diagnostic-prognostic-lab/ElbiCare/PCB/PicoAcoustic v3/PicoAcoustic v3.kicad_pcb

## KiCad design PCB/PicoAcoustic v3/PicoAcoustic v3.kicad_pcb (2026-11-07)

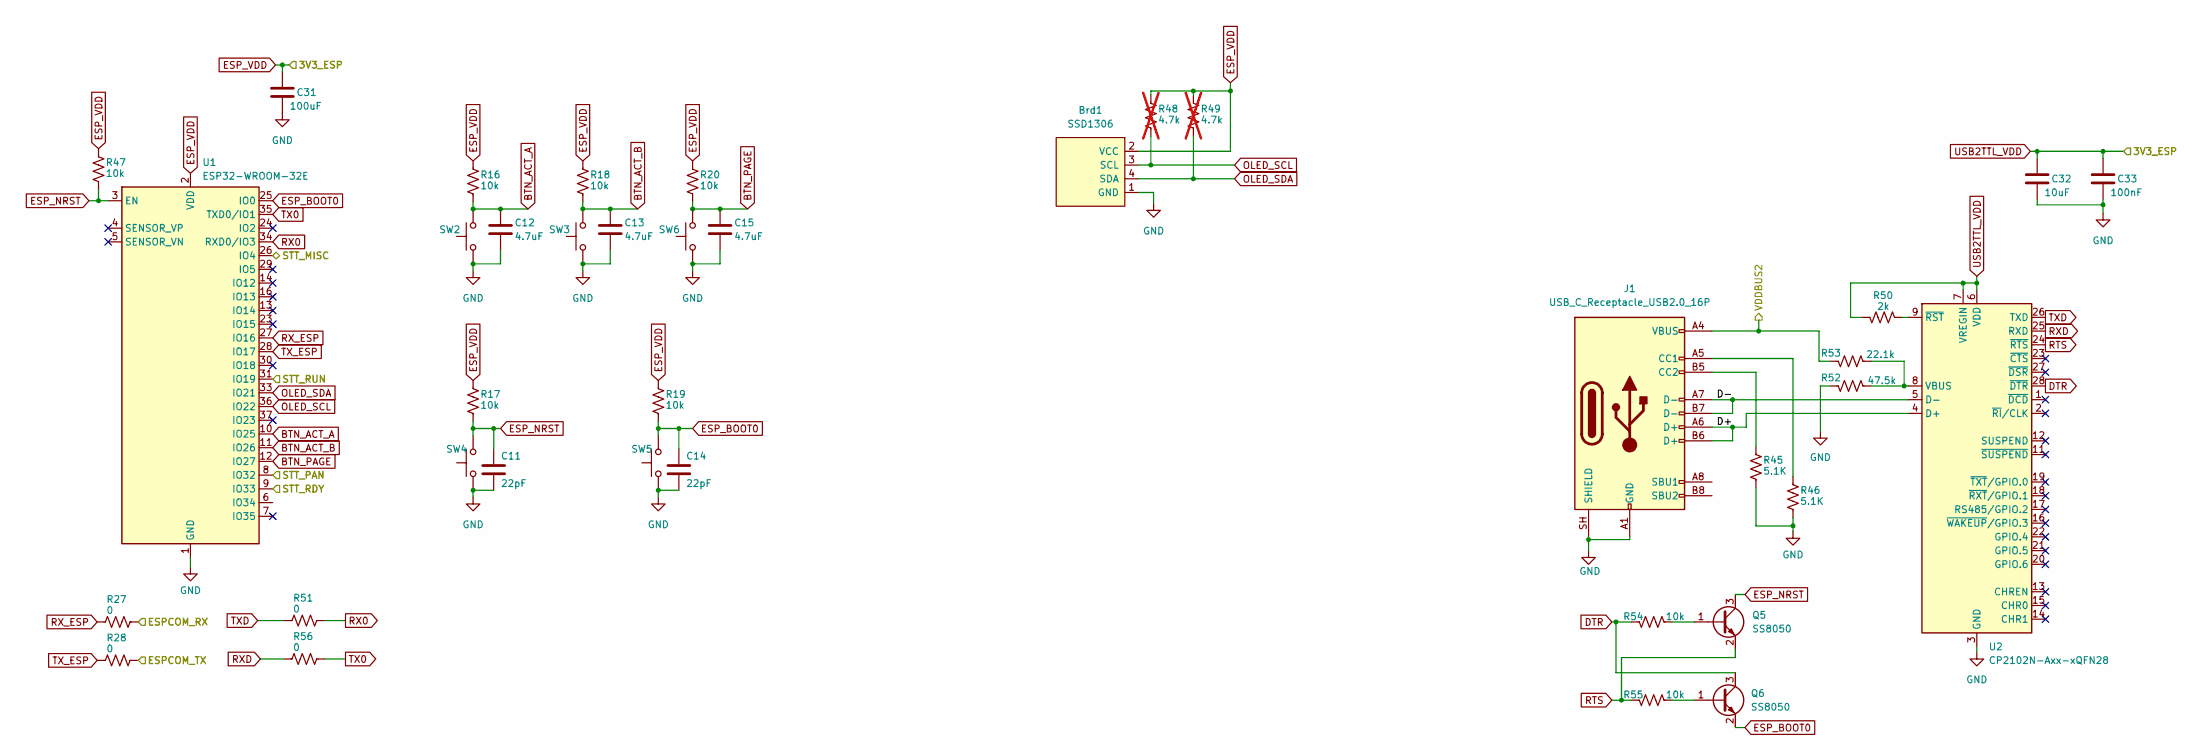
[picture p1: schematic esp32.kicad_sch]

Parts:
Brd1: SSD1306; LCD_OLED_128X64_1.3_I2C
C11, C14: 22pF; C_0603_1608Metric
C12, C13, C15: 4.7uF; C_0603_1608Metric
C31: 100uF; C_0603_1608Metric
C32: 10uF; C_0805_2012Metric
C33: 100nF; C_0603_1608Metric
J1: USB_C_Receptacle_USB2.0_16P; USB_C_Receptacle_G-Switch_GT-USB-7010ASV
Q5, Q6: SS8050; SOT-23
R16, R17, R18, R19, R20, R47, R54, R55: 10k; R_0603_1608Metric
R27, R28, R51, R56: 0; R_0603_1608Metric
R45, R46: 5.1K; R_0603_1608Metric
R48, R49: 4.7k; R_0603_1608Metric; not fitted
R50: 2k; R_0603_1608Metric
R52: 47.5k; R_0603_1608Metric
R53: 22.1k; R_0603_1608Metric
SW2, SW3, SW4, SW5, SW6: SW_Push; SW_PUSH_6mm_H13mm
U1: ESP32-WROOM-32E; ESP32-WROOM-32D
U2: CP2102N-Axx-xQFN28; QFN-28-1EP_5x5mm_P0.5mm_EP3.25x3.25mm_ThermalVias

Connections:
/ESP32/D+: J1.A6 (D+), J1.B6 (D+), U2.4 (D+)
/ESP32/D-: J1.A7 (D-), J1.B7 (D-), U2.5 (D-)
/ESP32/ESPCOM_RX: R27.2; also elsewhere on the board
/ESP32/ESPCOM_TX: R28.2; also elsewhere on the board
/ESP32/STT_MISC: U1.26 (IO4); also elsewhere on the board
/ESP32/STT_PAN: U1.8 (IO32); also elsewhere on the board
/ESP32/STT_RDY: U1.9 (IO33); also elsewhere on the board
/ESP32/STT_RUN: U1.31 (IO19); also elsewhere on the board
/ESP32/VDDBUS2: J1.A4 (VBUS), J1.A9 (VBUS), J1.B4 (VBUS), J1.B9 (VBUS), R53.2; also elsewhere on the board
BTN_ACT_A: C12.1, R16.2, SW2.2, U1.10 (IO25)
BTN_ACT_B: C13.1, R18.2, SW3.2, U1.11 (IO26)
BTN_PAGE: C15.1, R20.2, SW6.2, U1.12 (IO27)
DTR: Q6.3 (C), R54.2, U2.28 (~DTR)
ESP_BOOT0: C14.1, Q6.2 (E), R19.2, SW5.2, U1.25 (IO0)
ESP_NRST: C11.1, Q5.3 (C), R17.2, R47.2, SW4.2, U1.3 (EN)
ESP_VDD: Brd1.2 (VCC), C31.1, C32.1, C33.1, R16.1, R17.1, R18.1, R19.1, R20.1, R47.1, R48.1, R49.1, R50.2, U1.2 (VDD), U2.6 (VDD), U2.7 (VREGIN); also elsewhere on the board
GND: Brd1.1 (GND), C11.2, C12.2, C13.2, C14.2, C15.2, C31.2, C32.2, C33.2, J1.A1 (GND), J1.A12 (GND), J1.B1 (GND), J1.B12 (GND), J1.SH (SHIELD), R45.2, R46.2, R52.2, SW2.1, SW3.1, SW4.1, SW5.1, SW6.1, U1.1 (GND), U1.15 (GND), U1.38 (GND), U1.39 (GND), U2.3 (GND), U2.29 (GND); also elsewhere on the board
unnamed: J1.A5 (CC1), R46.1
unnamed: J1.B5 (CC2), R45.1
unnamed: Q5.1 (B), R54.1
unnamed: Q6.1 (B), R55.1
unnamed: R52.1, R53.1, U2.8 (VBUS)
unnamed: R50.1, U2.9 (~RST)
OLED_SCL: Brd1.3 (SCL), R48.2, U1.36 (IO22)
OLED_SDA: Brd1.4 (SDA), R49.2, U1.33 (IO21)
RTS: Q5.2 (E), R55.2, U2.24 (~RTS)
RX0: R51.2, U1.34 (RXD0/IO3)
RXD: R56.1, U2.25 (RXD)
RX_ESP: R27.1, U1.27 (IO16)
TX0: R56.2, U1.35 (TXD0/IO1)
TXD: R51.1, U2.26 (TXD)
TX_ESP: R28.1, U1.28 (IO17)

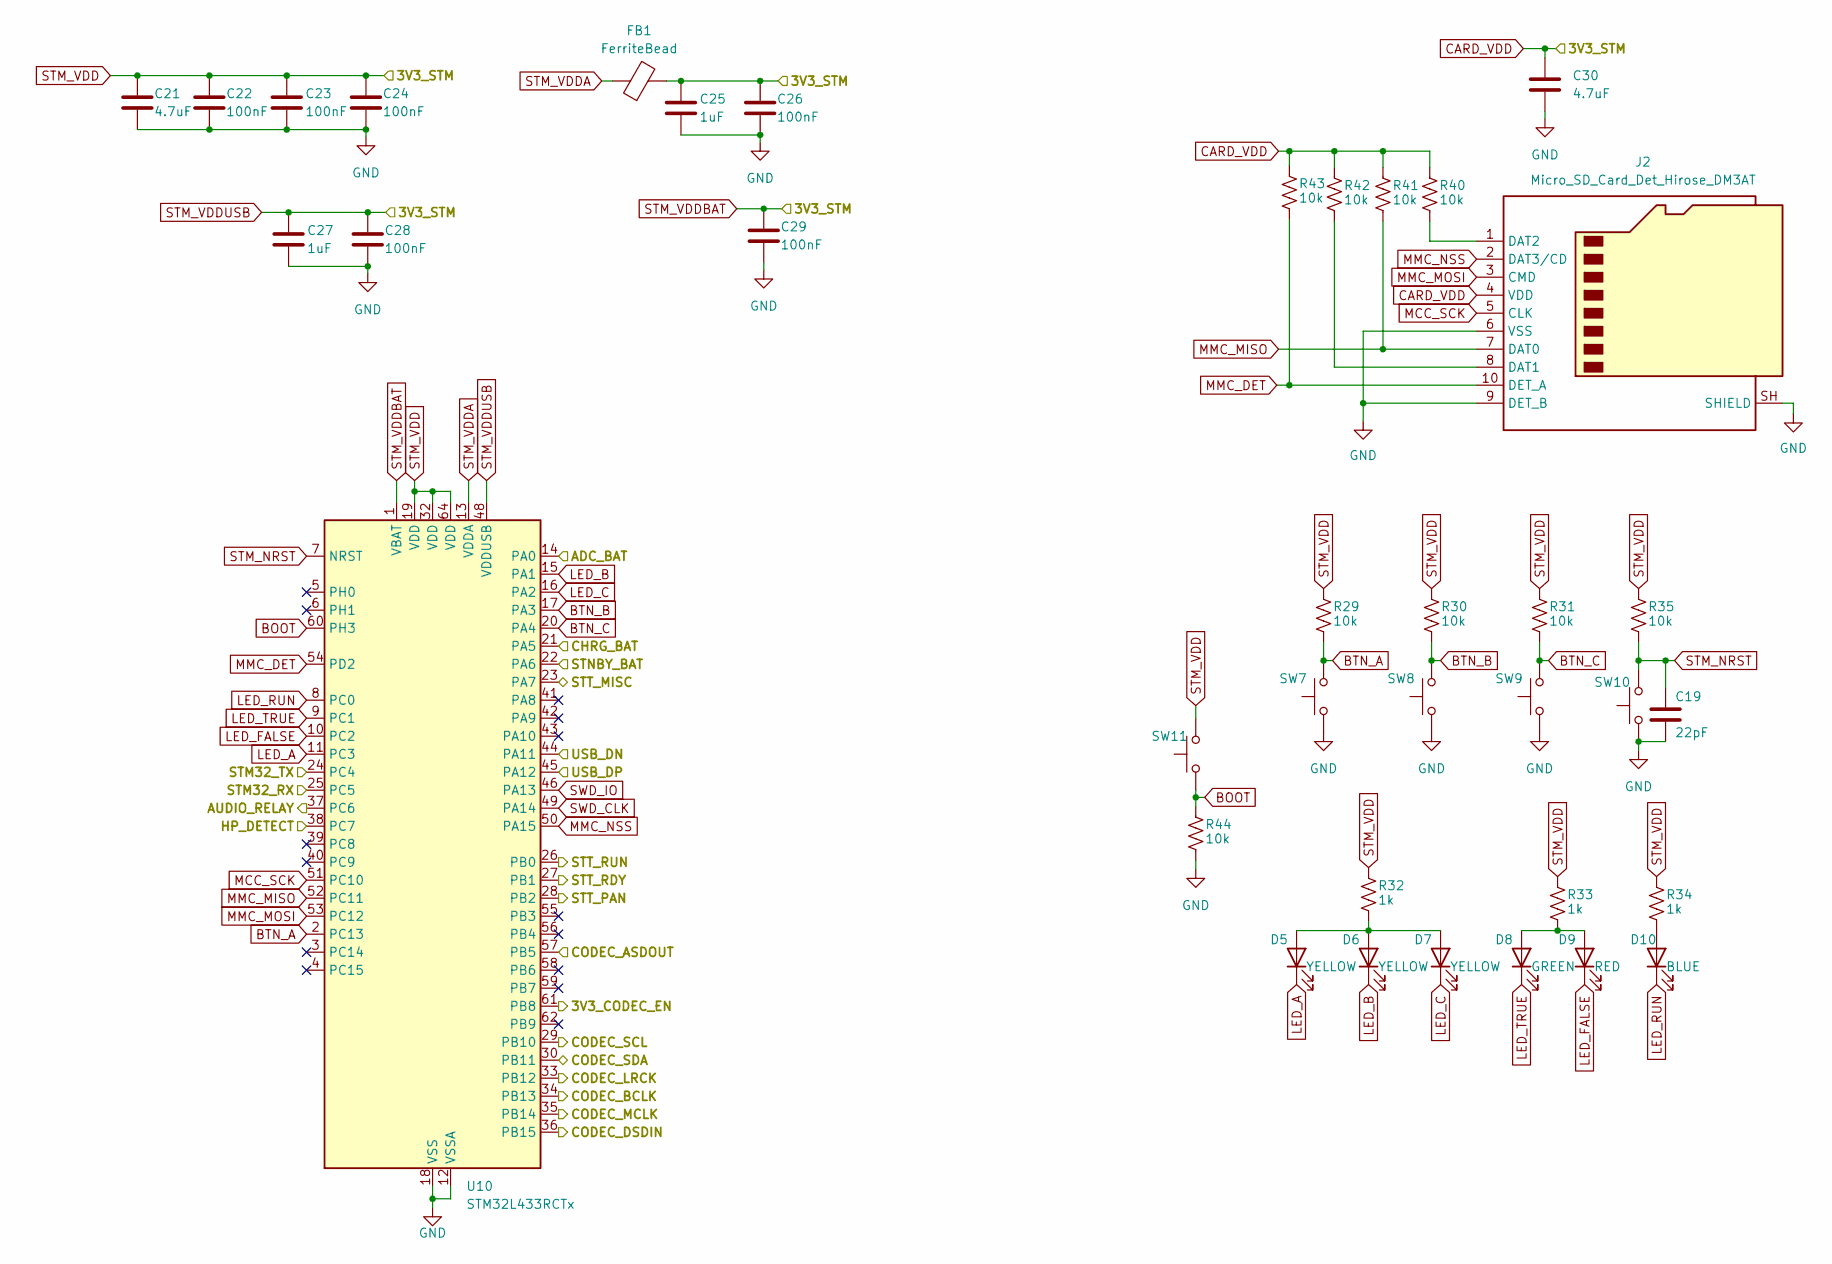
[picture p2: schematic stm32.kicad_sch]

Parts:
C19: 22pF; C_0603_1608Metric
C21, C30: 4.7uF; C_0603_1608Metric
C22, C23, C24, C26, C28, C29: 100nF; C_0603_1608Metric
C25, C27: 1uF; C_0603_1608Metric
D5, D6, D7: YELLOW; LED_0603_1608Metric
D8: GREEN; LED_0603_1608Metric
D9: RED; LED_0603_1608Metric
D10: BLUE; LED_0603_1608Metric
FB1: FerriteBead; L_0603_1608Metric
J2: Micro_SD_Card_Det_Hirose_DM3AT; microSD_HC_Hirose_DM3AT-SF-PEJM5
R29, R30, R31, R35, R40, R41, R42, R43, R44: 10k; R_0603_1608Metric
R32, R33, R34: 1k; R_0603_1608Metric
SW7, SW8, SW9, SW10, SW11: SW_Push; SW_PUSH_6mm_H13mm
U10: STM32L433RCTx; LQFP-64_10x10mm_P0.5mm

Connections:
/Analog Line/AUDIO_RELAY: U10.37 (PC6); also elsewhere on the board
/Analog Line/CODEC_ASDOUT: U10.57 (PB5); also elsewhere on the board
/Analog Line/CODEC_DSDIN: U10.36 (PB15); also elsewhere on the board
/Analog Line/CODEC_LRCK: U10.33 (PB12); also elsewhere on the board
/Analog Line/CODEC_MCLK: U10.35 (PB14); also elsewhere on the board
/Analog Line/CODEC_SCL: U10.29 (PB10); also elsewhere on the board
/Analog Line/CODEC_SCLK: U10.34 (PB13); also elsewhere on the board
/Analog Line/CODEC_SDA: U10.30 (PB11); also elsewhere on the board
/Analog Line/HP_DETECT: U10.38 (PC7); also elsewhere on the board
/ESP32/ESPCOM_RX: U10.24 (PC4); also elsewhere on the board
/ESP32/ESPCOM_TX: U10.25 (PC5); also elsewhere on the board
/ESP32/STT_MISC: U10.23 (PA7); also elsewhere on the board
/ESP32/STT_PAN: U10.28 (PB2); also elsewhere on the board
/ESP32/STT_RDY: U10.27 (PB1); also elsewhere on the board
/ESP32/STT_RUN: U10.26 (PB0); also elsewhere on the board
/Power Line/3V3_CODEC_EN: U10.61 (PB8); also elsewhere on the board
/Power Line/STM_DN: U10.44 (PA11); also elsewhere on the board
/Power Line/STM_DP: U10.45 (PA12); also elsewhere on the board
/Power Line/VBAT_SENSE: U10.14 (PA0); also elsewhere on the board
BOOT: R44.1, SW11.1, U10.60 (PH3)
BTN_A: R29.2, SW7.2, U10.2 (PC13)
BTN_B: R30.2, SW8.2, U10.17 (PA3)
BTN_C: R31.2, SW9.2, U10.20 (PA4)
CARD_VDD: C21.1, C22.1, C23.1, C24.1, C25.1, C26.1, C27.1, C28.1, C29.1, C30.1, FB1.2, J2.4 (VDD), R29.1, R30.1, R31.1, R32.1, R33.1, R34.1, R35.1, R40.1, R41.1, R42.1, R43.1, SW11.2, U10.1 (VBAT), U10.19 (VDD), U10.32 (VDD), U10.48 (VDDUSB), U10.64 (VDD); also elsewhere on the board
CHRG: U10.21 (PA5); also elsewhere on the board
GND: C19.2, C21.2, C22.2, C23.2, C24.2, C25.2, C26.2, C27.2, C28.2, C29.2, C30.2, J2.6 (VSS), J2.9 (DET_B), J2.SH (SHIELD), R44.2, SW7.1, SW8.1, SW9.1, SW10.1, U10.12 (VSSA), U10.18 (VSS), U10.31 (VSS), U10.47 (VSS), U10.63 (VSS); also elsewhere on the board
LED_A: D5.1 (K), U10.11 (PC3)
LED_B: D6.1 (K), U10.15 (PA1)
LED_C: D7.1 (K), U10.16 (PA2)
LED_FALSE: D9.1 (K), U10.10 (PC2)
LED_RUN: D10.1 (K), U10.8 (PC0)
LED_TRUE: D8.1 (K), U10.9 (PC1)
MCC_SCK: J2.5 (CLK), U10.51 (PC10)
MMC_DET: J2.10 (DET_A), R43.2, U10.54 (PD2)
MMC_MISO: J2.7 (DAT0), R41.2, U10.52 (PC11)
MMC_MOSI: J2.3 (CMD), U10.53 (PC12)
MMC_NSS: J2.2 (DAT3/CD), U10.50 (PA15)
unnamed: D5.2 (A), D6.2 (A), D7.2 (A), R32.2
unnamed: D8.2 (A), D9.2 (A), R33.2
unnamed: D10.2 (A), R34.2
unnamed: J2.8 (DAT1), R42.2
unnamed: J2.1 (DAT2), R40.2
STM_NRST: C19.1, R35.2, SW10.2, U10.7 (NRST)
STM_VDDA: FB1.1, U10.13 (VDDA)
STNBY: U10.22 (PA6); also elsewhere on the board
SWD_CLK: U10.49 (PA14)
SWD_IO: U10.46 (PA13)

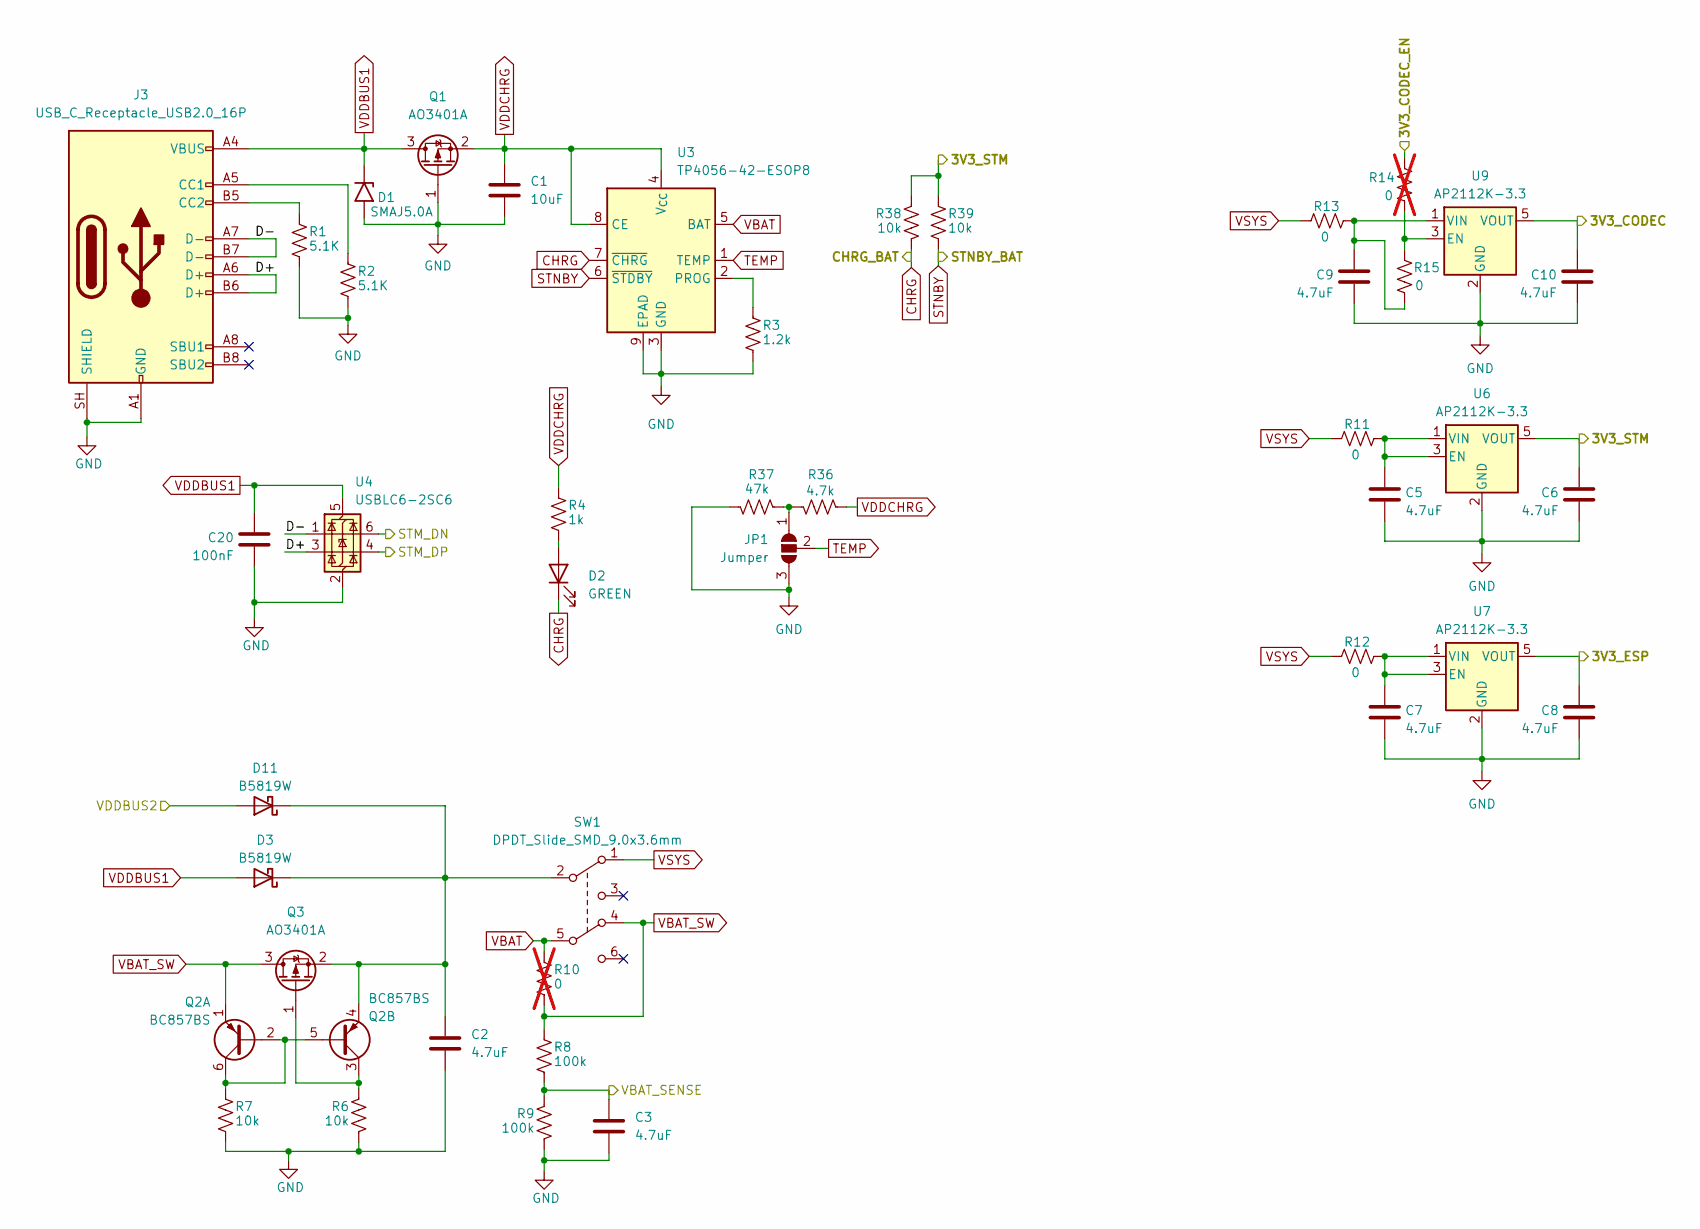
[picture p3: schematic power_line.kicad_sch]

Parts:
C1: 10uF; C_0603_1608Metric
C2, C3, C5, C6, C7, C8, C9, C10: 4.7uF; C_0603_1608Metric
C20: 100nF; C_0603_1608Metric
D1: SMAJ5.0A; D_SMA
D2: GREEN; LED_0603_1608Metric
D3, D11: B5819W; D_SMA
J3: USB_C_Receptacle_USB2.0_16P; USB_C_Receptacle_G-Switch_GT-USB-7010ASV
JP1: Jumper; SolderJumper-3_P1.3mm_Open_RoundedPad1.0x1.5mm_NumberLabels
Q1, Q3: AO3401A; SOT-23
Q2: BC857BS; SOT-363_SC-70-6
R1, R2: 5.1K; R_0603_1608Metric
R3: 1.2k; R_0603_1608Metric
R4: 1k; R_0603_1608Metric
R6, R7, R38, R39: 10k; R_0603_1608Metric
R8, R9: 100k; R_0603_1608Metric
R10, R14: 0; R_0603_1608Metric; not fitted
R11, R12, R13, R15: 0; R_0603_1608Metric
R36: 4.7k; R_0603_1608Metric
R37: 47k; R_0603_1608Metric
SW1: DPDT_Slide_SMD_9.0x3.6mm; SW_Push_2P2T_Toggle_CK_PVA2xxH1xxxxxxV2
U3: TP4056-42-ESOP8; SOIC-8-1EP_3.9x4.9mm_P1.27mm_EP2.41x3.3mm_ThermalVias
U4: USBLC6-2SC6; SOT-23-6
U6, U7, U9: AP2112K-3.3; SOT-23-5

Connections:
/ESP32/VDDBUS2: D11.2 (A); also elsewhere on the board
/Power Line/3V3_CODEC_EN: R14.2; also elsewhere on the board
/Power Line/D+: J3.A6 (D+), J3.B6 (D+), U4.3 (I/O2)
/Power Line/D-: J3.A7 (D-), J3.B7 (D-), U4.1 (I/O1)
/Power Line/STM_DN: U4.6 (I/O1); also elsewhere on the board
/Power Line/STM_DP: U4.4 (I/O2); also elsewhere on the board
/Power Line/VBAT_SENSE: C3.1, R8.2, R9.1; also elsewhere on the board
AVDD: C10.1, U9.5 (VOUT); also elsewhere on the board
CARD_VDD: C6.1, R38.1, R39.1, U6.5 (VOUT); also elsewhere on the board
CHRG: D2.1 (K), R38.2, U3.7 (~CHRG); also elsewhere on the board
ESP_VDD: C8.1, U7.5 (VOUT); also elsewhere on the board
GND: C1.2, C2.2, C3.2, C5.2, C6.2, C7.2, C8.2, C9.2, C10.2, C20.2, D1.2 (A2), J3.A1 (GND), J3.A12 (GND), J3.B1 (GND), J3.B12 (GND), J3.SH (SHIELD), JP1.3 (B), Q1.1 (G), R1.2, R2.2, R3.2, R6.2, R7.2, R9.2, R37.2, U3.3 (GND), U3.9 (EPAD), U4.2 (GND), U6.2 (GND), U7.2 (GND), U9.2 (GND); also elsewhere on the board
unnamed: D2.2 (A), R4.2
unnamed: C2.1, D3.1 (K), D11.1 (K), Q2.4 (E2), Q3.2 (S), SW1.2 (B)
unnamed: J3.A5 (CC1), R2.1
unnamed: J3.B5 (CC2), R1.1
unnamed: JP1.1 (A), R36.2, R37.1
unnamed: Q2.2 (B1), Q2.5 (B2), Q2.6 (C1), R7.1
unnamed: Q2.3 (C2), Q3.1 (G), R6.1
unnamed: R3.1, U3.2 (PROG)
unnamed: C5.1, R11.2, U6.1 (VIN), U6.3 (EN)
unnamed: C7.1, R12.2, U7.1 (VIN), U7.3 (EN)
unnamed: R14.1, R15.2, U9.3 (EN)
unnamed: C9.1, R13.2, R15.1, U9.1 (VIN)
STNBY: R39.2, U3.6 (~STDBY); also elsewhere on the board
TEMP: JP1.2 (C), U3.1 (TEMP)
VBAT: R10.1, SW1.5 (B), U3.5 (BAT)
VBAT_SW: Q2.1 (E1), Q3.3 (D), R8.1, R10.2, SW1.4 (A)
VDDBUS1: C20.1, D1.1 (A1), D3.2 (A), J3.A4 (VBUS), J3.A9 (VBUS), J3.B4 (VBUS), J3.B9 (VBUS), Q1.3 (D), U4.5 (VBUS)
VDDCHRG: C1.1, Q1.2 (S), R4.1, R36.1, U3.4 (V_{CC}), U3.8 (CE)
VSYS: R11.1, R12.1, R13.1, SW1.1 (A)

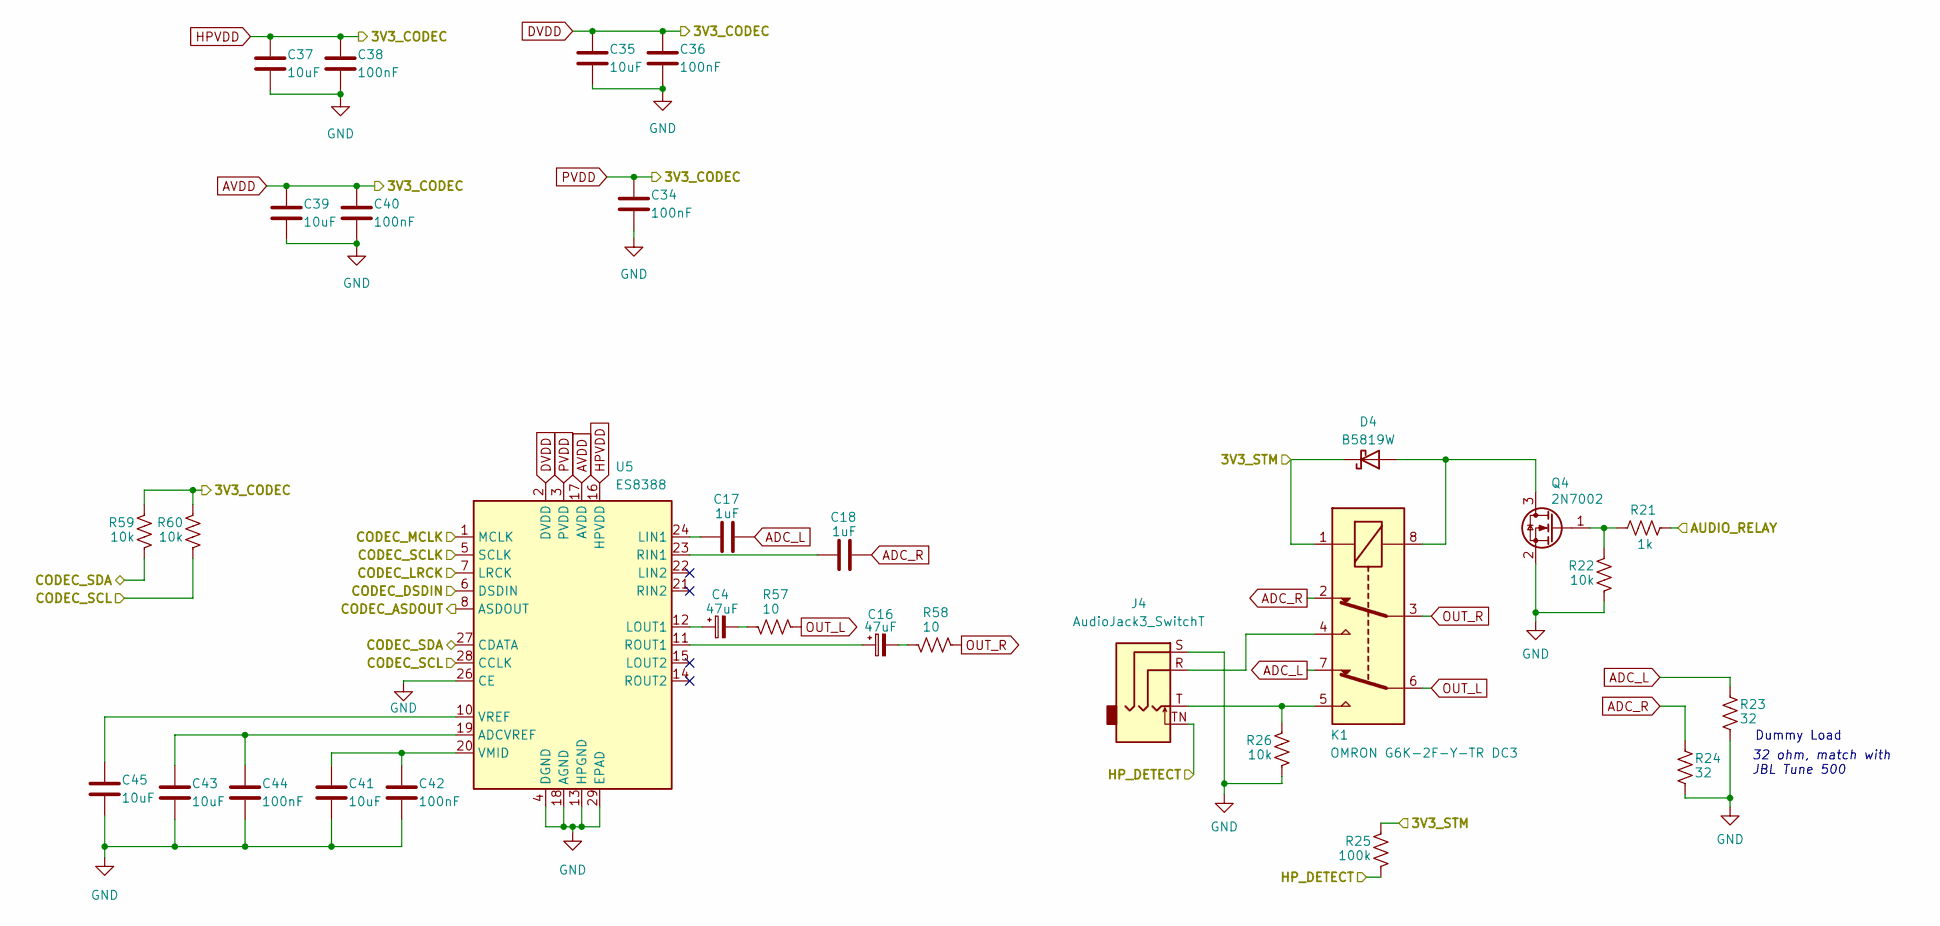
[picture p4: schematic analog_line.kicad_sch]

Parts:
C4, C16: 47uF; CP_Elec_5x5.7
C17, C18: 1uF; C_0603_1608Metric
C34, C36, C38, C40, C42, C44: 100nF; C_0603_1608Metric
C35, C37, C39, C41, C43, C45: 10uF; C_0805_2012Metric
D4: B5819W; D_SMA
J4: AudioJack3_SwitchT; Jack_3.5mm_CUI_SJ-3524-SMT_Horizontal
K1: OMRON G6K-2F-Y-TR DC3; Relay_DPDT_Omron_G6K-2F-Y
Q4: 2N7002; SOT-23
R21: 1k; R_0603_1608Metric
R22, R26, R59, R60: 10k; R_0603_1608Metric
R23, R24: 32; R_0603_1608Metric
R25: 100k; R_0603_1608Metric
R57, R58: 10; R_0603_1608Metric
U5: ES8388; QFN-28-1EP_4x4mm_P0.45mm_EP2.6x2.6mm

Connections:
/Analog Line/AUDIO_RELAY: R21.2; also elsewhere on the board
/Analog Line/CODEC_ASDOUT: U5.8 (ASDOUT); also elsewhere on the board
/Analog Line/CODEC_DSDIN: U5.6 (DSDIN); also elsewhere on the board
/Analog Line/CODEC_LRCK: U5.7 (LRCK); also elsewhere on the board
/Analog Line/CODEC_MCLK: U5.1 (MCLK); also elsewhere on the board
/Analog Line/CODEC_SCL: R60.2, U5.28 (CCLK); also elsewhere on the board
/Analog Line/CODEC_SCLK: U5.5 (SCLK); also elsewhere on the board
/Analog Line/CODEC_SDA: R59.2, U5.27 (CDATA); also elsewhere on the board
/Analog Line/HP_DETECT: J4.TN, R25.2; also elsewhere on the board
ADC_L: C17.2, K1.7, R23.1
ADC_R: C18.2, K1.2, R24.1
AVDD: C34.1, C35.1, C36.1, C37.1, C38.1, C39.1, C40.1, R59.1, R60.1, U5.2 (DVDD), U5.3 (PVDD), U5.16 (HPVDD), U5.17 (AVDD); also elsewhere on the board
CARD_VDD: D4.1 (K), K1.1, R25.1; also elsewhere on the board
GND: C34.2, C35.2, C36.2, C37.2, C38.2, C39.2, C40.2, C41.2, C42.2, C43.2, C44.2, C45.2, J4.S, Q4.2 (S), R22.2, R23.2, R24.2, R26.2, U5.4 (DGND), U5.13 (HPGND), U5.18 (AGND), U5.26 (CE), U5.29 (EPAD); also elsewhere on the board
unnamed: C4.2, R57.2
unnamed: C16.2, R58.2
unnamed: D4.2 (A), K1.8, Q4.3 (D)
unnamed: J4.R, K1.4
unnamed: J4.T, K1.5, R26.1
unnamed: Q4.1 (G), R21.1, R22.1
unnamed: C43.1, C44.1, U5.19 (ADCVREF)
unnamed: C17.1, U5.24 (LIN1)
unnamed: C4.1, U5.12 (LOUT1)
unnamed: C18.1, U5.23 (RIN1)
unnamed: C16.1, U5.11 (ROUT1)
unnamed: C41.1, C42.1, U5.20 (VMID)
unnamed: C45.1, U5.10 (VREF)
OUT_L: K1.6, R57.1
OUT_R: K1.3, R58.1

Notes on the sheet:
32 ohm, match with JBL Tune 500
Dummy Load

Board: 2 copper layers, 149 parts (0 on the bottom side), 108 nets, no tracks yet.
