diagnostic-prognostic-lab/ElbiCare/(commit log)

2026-10-30 add pcb readme
2026-10-30 update kicad
    [PicoAcoustic v3.kicad_pcb, analog_line.kicad_sch]
2026-10-30 update kicadzzz
    [PicoAcoustic v3.kicad_sch, analog_line.kicad_sch, esp32.kicad_sch, stm32.kicad_sch]
2026-11-03 update sch ajah
    [PicoAcoustic v3.kicad_pcb, analog_line.kicad_sch, esp32.kicad_sch, power_line.kicad_sch, stm32.kicad_sch]
2026-11-05 semoga sch sudah selesai
    [PicoAcoustic v3.kicad_pcb, PicoAcoustic v3.kicad_sch, analog_line.kicad_sch, esp32.kicad_sch, power_line.kicad_sch, stm32.kicad_sch]
2026-11-05 update sch
    [PicoAcoustic v3.kicad_pcb, PicoAcoustic v3.kicad_sch, esp32.kicad_sch, power_line.kicad_sch, stm32.kicad_sch]
2026-11-07 update pcb
    [PicoAcoustic v3.kicad_pcb]
